siliconwiz/sky130_comparator_ip/Images/CircuitDiagram.png

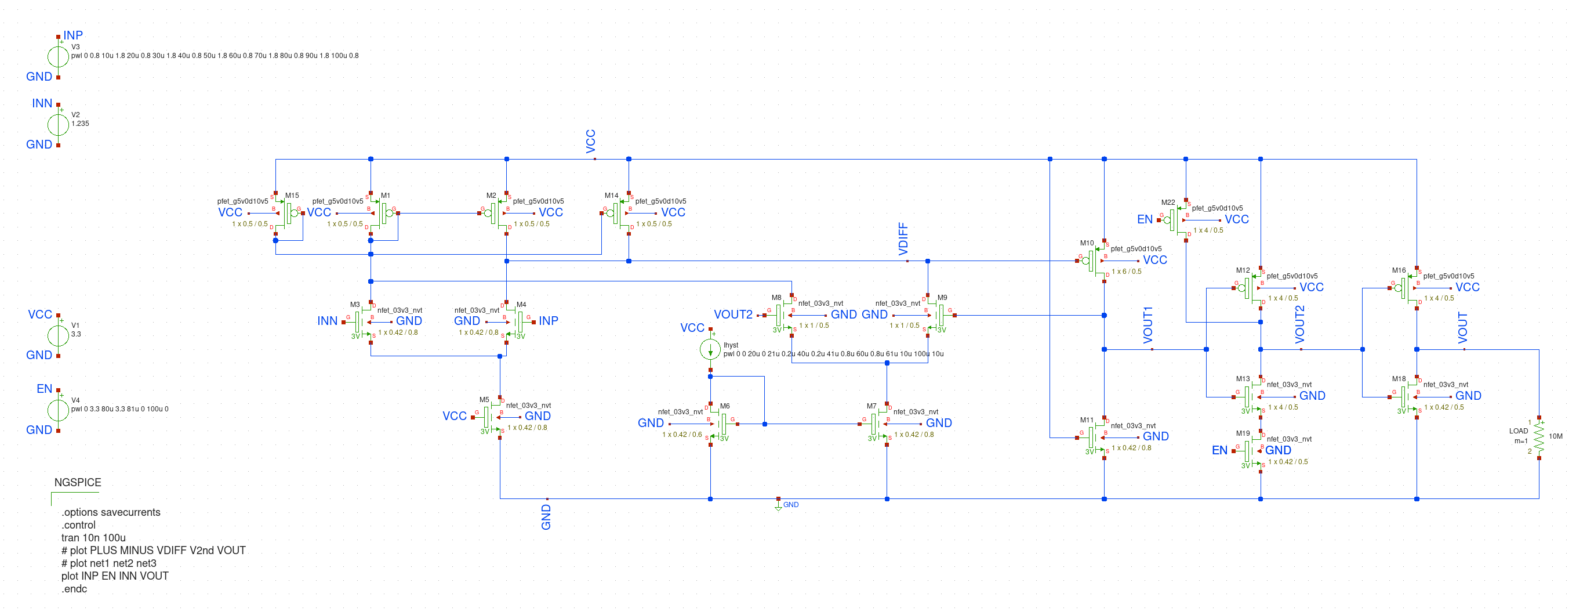
Images/CircuitDiagram.png
