siliconwiz/sky130_comparator_ip/Images/hysteresis_10uA.jpg

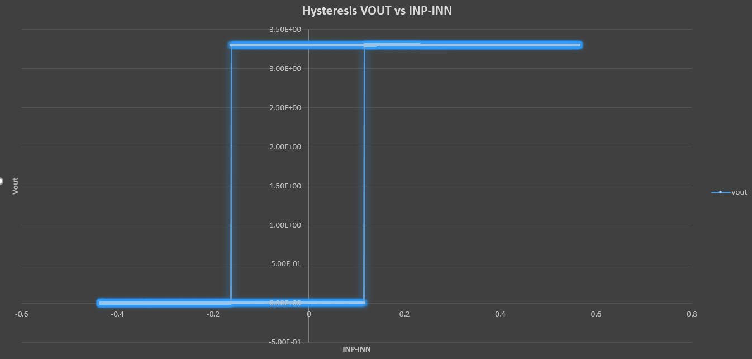
Images/hysteresis_10uA.jpg
