siliconwiz/sky130_comparator_ip/Images/ngspice_0.5m_ihyst_all.png

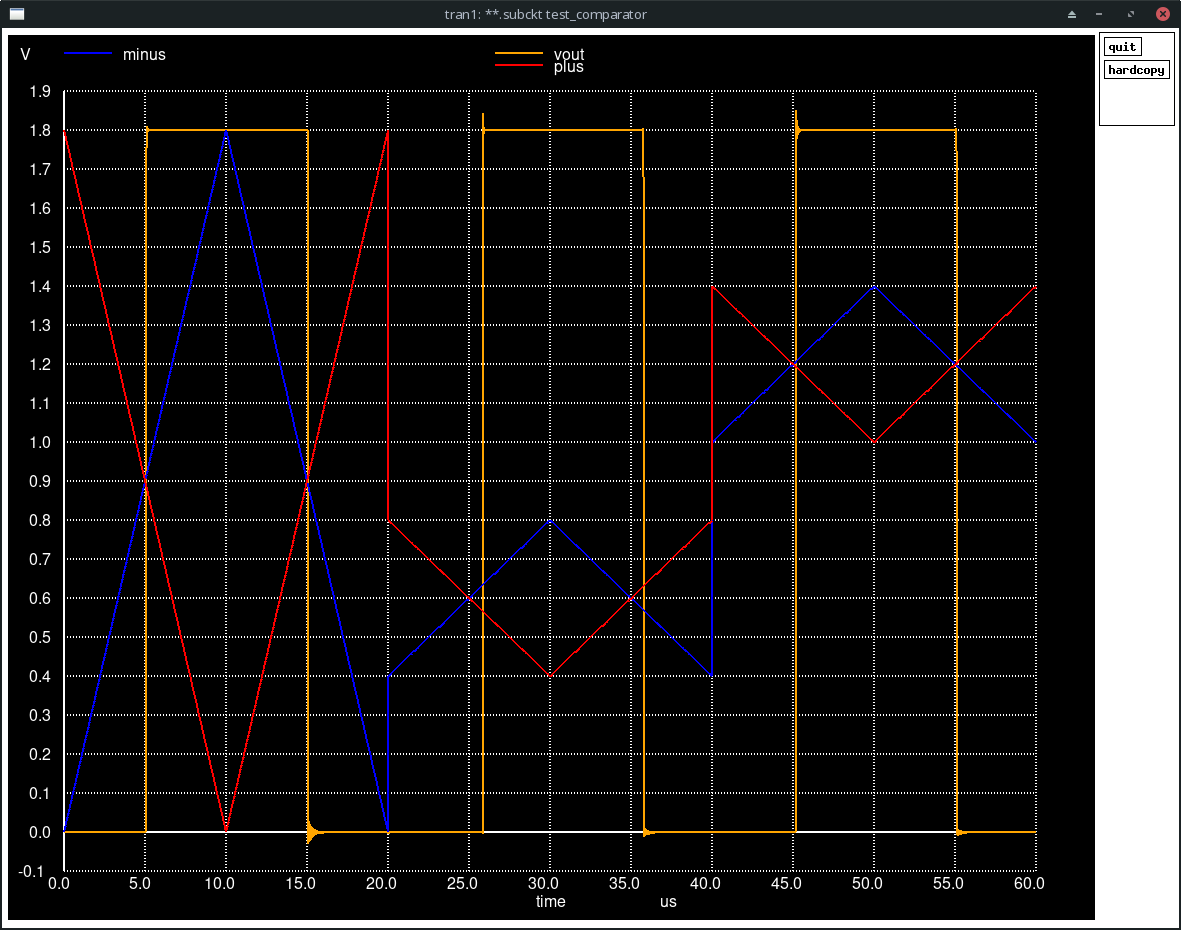
Images/ngspice_0.5m_ihyst_all.png
