siliconwiz/sky130_comparator_ip/Images/ngspice_0.5m_ihyst_closeup_1.2v.png

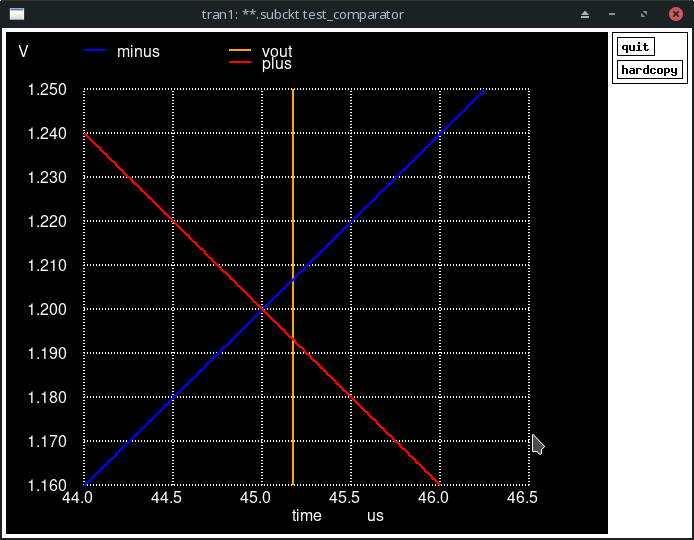
Images/ngspice_0.5m_ihyst_closeup_1.2v.png
