siliconwiz/sky130_comparator_ip/Images/ngspice_2m_ihyst_all.png

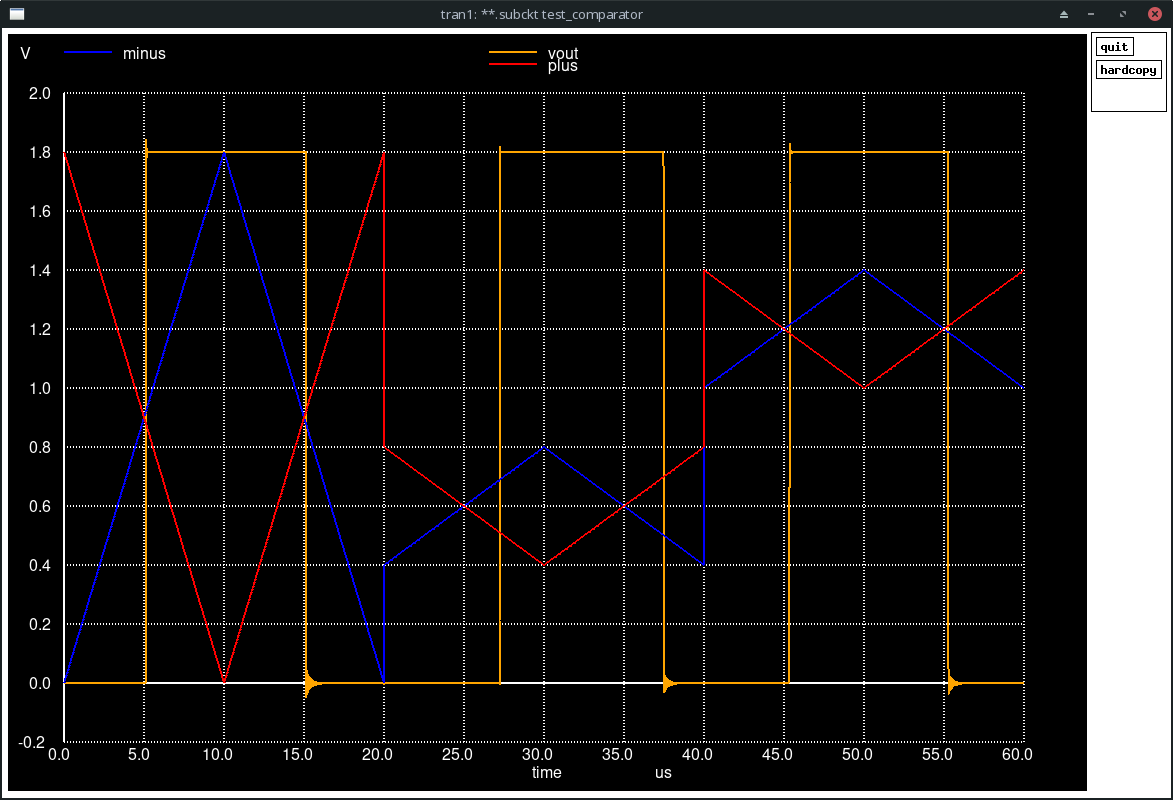
Images/ngspice_2m_ihyst_all.png
