siliconwiz/sky130_comparator_ip/Images/ngspice_outdiff.png

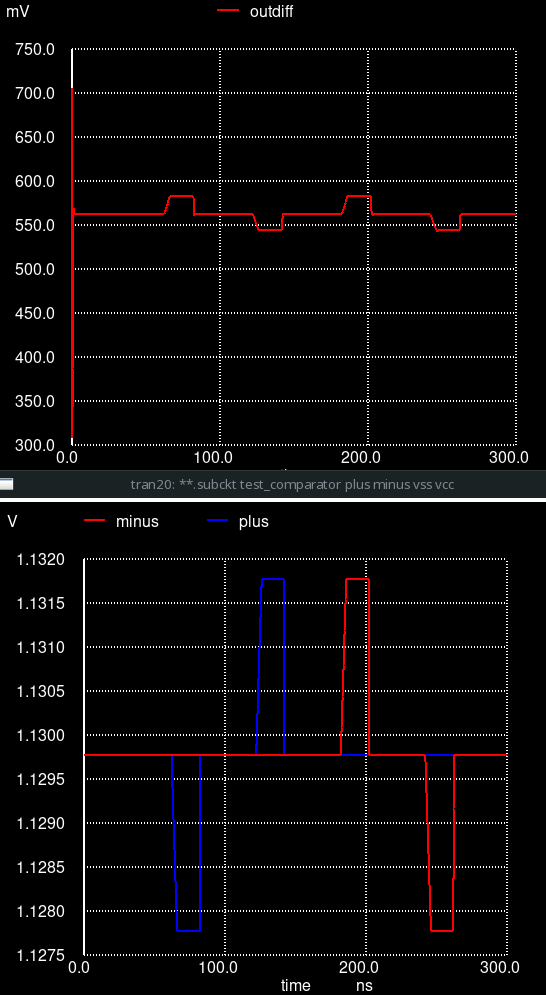
Images/ngspice_outdiff.png
