siliconwiz/sky130_comparator_ip/Layout/comparator_magic.png

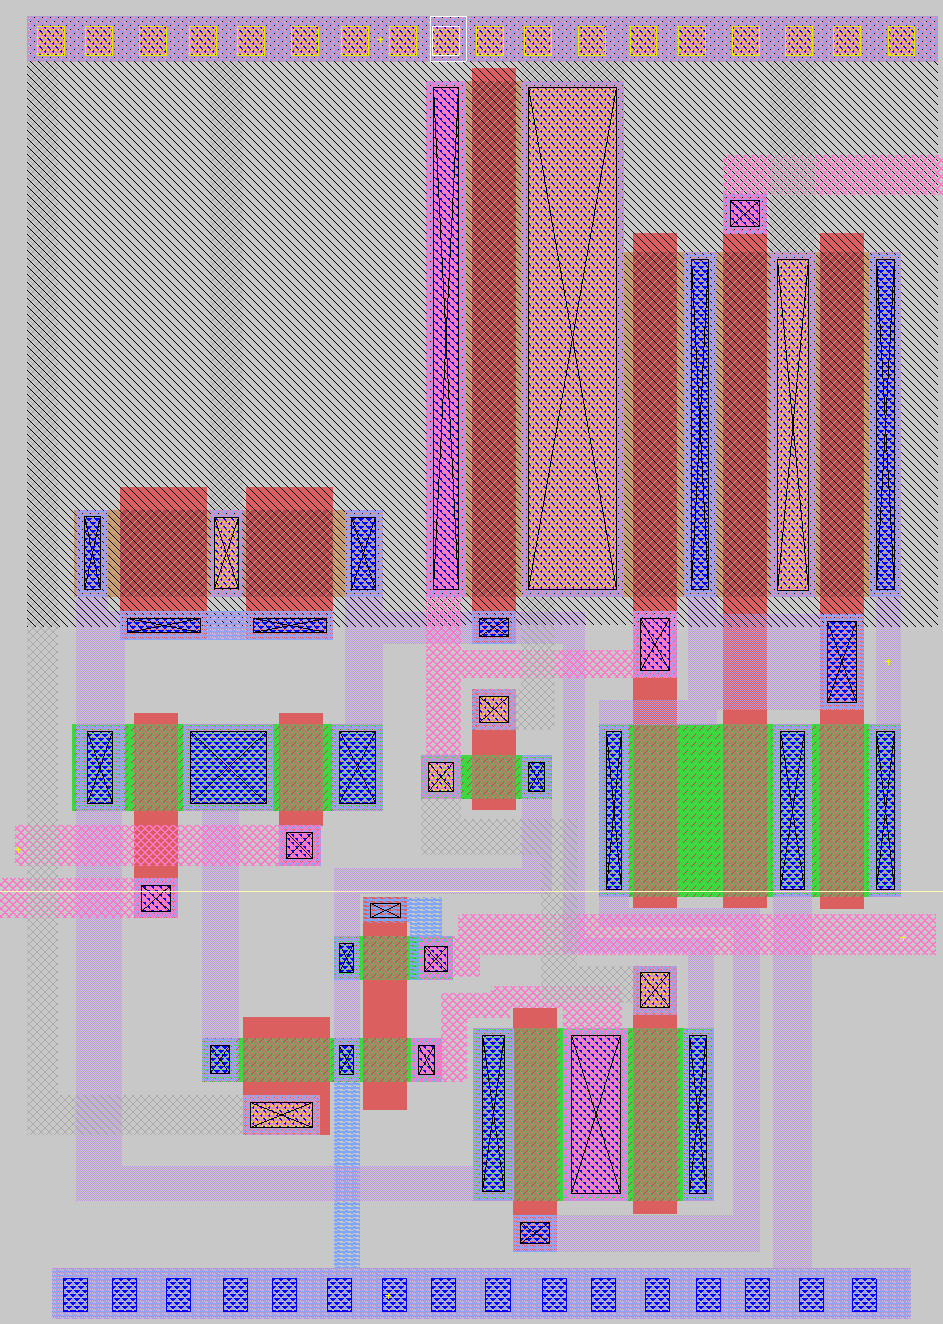
Layout/comparator_magic.png
