siliconwiz/sky130_comparator_ip/(commit log)

2021-02-19 added circuit and simulations
    [comparator.sch, comparator_hyst_inverter.sch, comparator_ibias.sch, comparator_inverter.sch]
2021-02-23 Changed 1v8 cells to 3v3 and 5v0. Added ENABLE pin
    [comparator.sch, comparator_1v8.sch]
2021-02-23 added one more current mirror and an addtional inverter buffer
    [test_comparator.sch]
2021-02-23 Tried different enable/diable circuits. Modified test as per specs.
    [test_comparator.sch]
2021-02-25 changed position of enable pin.
    [test_comparator.sch]
2021-02-26 Added SKY130 files to help run spice with no external dependency.
    [comparator_3v3.sch, test_comparator.sch]
2021-02-26 added simulation images
    [comparator.sch, comparator_3v3.sch, test_comparator.sch]
2021-02-26 added circuit description
2021-03-10 updated circuit replacing 3v3 with 5v0 nfets
    [test_comparator.sch]
2021-03-10 finetuned the circuit and updated the spice
    [comparator.sch, test_comparator.sch]
